kjt7942/grape-sorter/README.md

# grape-sorter

꿀송이농장 포도선별기.

라즈베리파이 + 7인치 터치스크린(800x480)에서 도는 선별 제어 프로그램입니다.
아두이노 메가 2560에 붙은 12채널 로드셀(HX711)에서 무게를 받아, 목표무게에 가장
가까운 조합을 찾아 해당 저울의 LED를 켭니다.

```
[로드셀 x12] --HX711--> [Arduino Mega 2560] --USB 시리얼 115200--> [Raspberry Pi]
                                 ^                                        |
                                 +------------ LED 점등 명령 -------------+
```

## 목적

박스 하나에 포도를 담을 때 목표무게(예: 2,050g)에 최대한 가깝게 맞춰야 하는데,
저울 12개에 흩어진 송이들 중 어떤 조합이 목표에 가장 가까운지 사람이 암산으로
고르기는 어렵습니다. 이 프로그램은 `itertools.combinations` 로 가능한 모든 조합을
전수 탐색해 최적 조합을 즉시 계산하고, 해당 저울의 LED를 켜서 작업자가 어떤
송이를 담아야 하는지 바로 알 수 있게 합니다.

현장(농장)에 무인/반무인으로 배포되는 키오스크 장비라, 개발 과정의 절반은
기능 추가보다 "전원만 넣으면 항상 정상 동작"을 보장하는 데 들어갔습니다 —
OTA 실패 자동 롤백, 시리얼 재연결, 설정 파일 원자적 저장 등 (아래 개발 기록 참고).

## 설치 (라즈베리파이)

```bash
git clone https://github.com/kjt7942/grape-sorter.git
cd grape-sorter
bash setup_kiosk.sh          # X11, PyQt5, PySerial, 자동시작, sudo 권한
sudo bash setup_boot_screen.sh   # (선택) 부팅 스플래시 화면
```

이후 `sudo raspi-config` 에서 Console Autologin 을 켜고 재부팅하면 전체화면으로 자동 실행됩니다.
자세한 절차와 트러블슈팅은 [dev_environment_spec.md](dev_environment_spec.md) 를 보세요.

## 개발 환경에서 실행

아두이노가 없으면 시뮬레이션 모드로 뜹니다. 저울 카드를 클릭해 무게를 만들고 조합 동작을 확인할 수 있습니다.

```bash
python3 main.py
```

## 파일 구성

| 파일 | 역할 |
|---|---|
| `main.py` | 시리얼 통신, 조합 연산, 설정/실적 저장, OTA |
| `main_ui.py` | PyQt5 화면 정의 (메인 + 다이얼로그 3종) |
| `arduino_firmware/` | 아두이노 메가 펌웨어 (로드셀 읽기, LED, 영점) |
| `test_sorter.py` | 조합 로직 자체 점검. PyQt5 없이 실행되며 OTA 검증 관문으로도 쓰임 |
| `tests/` | 화면·시작절차·조립단계별 테스트. [tests/README.md](tests/README.md) 참고 |
| `setup_kiosk.sh` | 라즈베리파이 키오스크 환경 구축 |
| `setup_boot_screen.sh` | 부팅 스플래시(Plymouth) 설정 |

## 실행 중 생기는 파일 (git 추적 안 함)

| 파일 | 내용 |
|---|---|
| `settings.json` | 프리셋 A~H, 저울 보정값, 마지막 설정 |
| `settings.backup.json` | 위 파일의 자동 백업 |
| `production.csv` | 박스 완성 실적 (시각, 목표/실제 무게, 사용 저울) |
| `sorter.log` | 실행 로그 (1MB 회전, 3개 보관) |

## 테스트

라즈베리파이나 아두이노 없이 개발 PC에서 전부 돕니다.

```bash
python3 tests/run_all.py         # 전체 (7개 스위트)
python3 tests/render_screens.py  # 모든 화면을 PNG 로 저장
python3 test_sorter.py           # 조합 로직만 (OTA 관문과 동일)
```

무엇을 지키는지는 [tests/README.md](tests/README.md) 에 정리돼 있습니다.

## 개발 기록

커밋 로그(`git log --reverse`) 기준. 2026-03 구간은 대부분 "Add files via
upload"로 커밋되어 있어 세부 시각별 로그로 재구성할 수 없고, 2026-08 하순부터
의미 단위 커밋 메시지로 남겼습니다.

**2026-03-14 ~ 2026-03-30 — 초기 구축**
PyQt5 UI, 시리얼 통신, 조합 연산 뼈대, 800x480 대응, 키오스크 자동시작 스크립트를
파일 업로드 방식으로 반복 커밋하며 완성.

**2026-08-29**
- 15:42 아두이노 DT/LED 핀 매핑 정리
- 16:05 OTA 시 아두이노 펌웨어 버전(git 커밋 해시)까지 검증하도록 추가
- 16:14 저울점검 다이얼로그 추가 — 12채널 상태, 채널별 LED 확인, 펌웨어 버전 비교
- 22:11 현장 무인 운영 하드닝 — OTA 실패 시 이전 커밋으로 자동 롤백, 시리얼 2초
  간격 자동 재연결, `settings.json` 원자적 저장 + 백업/복구, 시작 시 자동 영점과
  오영점 감지, `print()` 대신 회전 로그 파일
- 22:11 아두이노 — 영점 오프셋을 `[TARE]`로 보고, 커맨드 버퍼 오버플로 복구
- 22:11 `dev_environment_spec.md` / `README.md` 재작성
- 22:18 허브보드 증설·제거 시 오영점으로 오탐하던 버그 수정
- 22:35 오프스크린 테스트 스위트 추가 (하드웨어 없이 검증)
- 22:44 보태기(topup) 모드 실적 기록 버그 수정, 보정 중 LED 오작동 억제
- 22:53 라즈베리파이에 RTC가 없어 생기는 시각 오류 완화 — 미동기화 시 실적에
  "(시각미확인)" 표기

**2026-08-30**
- 14:43 저울 7번(20kg 로드셀) `calFactor` 보정
- 14:46 저울마다 로드셀 용량이 섞여 있어 보정 배율 허용범위 확대
- 14:50 보정 화면 영점대기 안내 폰트 확대
- 18:22 허브보드 3장의 SCK 라인을 각각 분리해 배선 부담 감소
- 18:55 보정 화면에서 저울 카드를 직접 탭해 해당 채널부터 보정 가능하게
- 23:25 버튼 눌림 피드백 추가, 화면 안내문구 정리

**2026-09-11 ~ 09-18**
- 조합 잠금 유지(저울을 일부 비워도 선택 유지), 5g 단위 반올림, 잠금 켜기/끄기 토글
- 저울 3번 `calFactor`를 실측 비율로 재계산
- 잠긴 저울을 전부 비우면 즉시 잠금 해제 후 다음 조합 탐색
- 잠긴 조합무게가 포도 정착으로 늘어난 무게를 따라가되, 0.5초 유지된 값만 반영
- 조합 카드 터치 시 거절·순환 동작 제거 (같은 무게면 같은 최적 조합)

**2026-09-24 — 측정 안정화 (하드웨어 변경 없이)**
빈 저울 실측(10Hz, 채널 노이즈 표준편차 ≤1.1g)으로 기준을 잡고, 원인을 하나씩 좁혀가며 수정.
- 13:35 단발 ERR 이 잠긴 조합을 풀던 버그 수정 — 연속 5회까지 직전 정상값 유지.
  시리얼 수신을 증분 UTF-8 디코딩으로 바꿔 거의 매일 나던 "시작 준비 실패" 해결
- 13:47 새 조합은 무게가 0.5초 안정된 저울로만 잠금 (올리는 중인 송이 제외)
- 13:48 펌웨어 — HX711 준비 판정을 한 번의 스캔으로 통일, SCK HIGH 구간 인터럽트 차단,
  영점을 10회 평균 대신 위아래 2개씩 버린 절사평균으로
- 13:57 물리적으로 불가능한 값(-50g 미만, 25kg 초과)도 깨진 읽기로 보고 직전 값 유지
- 14:09 펌웨어 — HX711 원시값 0·포화값을 실패로 처리. 5번을 제외한 전 채널이 빈 상태
  120초 동안 이상값 0건
- 현장 설정: Wi-Fi 절전 끄기(SDIO 칩 정지 대응), 키오스크 `.xinitrc` 를 재시작 루프 버전으로 교체

## 스크린샷

`tests/render_screens.py` 로 캡처한 실제 화면입니다 (`docs/screenshots/`).

| 메인 화면 (다크) | 저울 정밀 보정 | 저울(로드셀) 점검 |
|---|---|---|
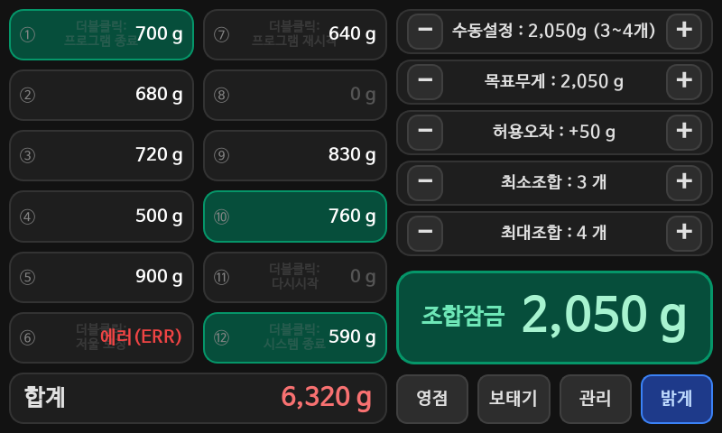
[picture p1: docs/screenshots/01_main_screen.png]
메인 화면
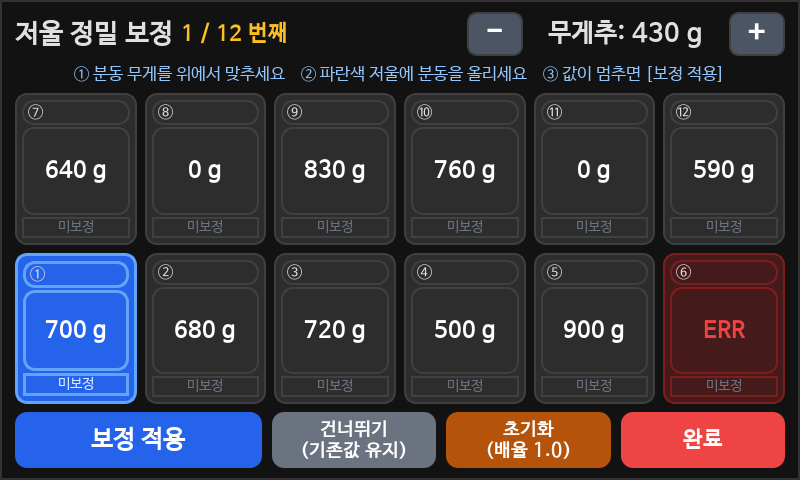
[picture p2: docs/screenshots/02_calibration.png]
보정 화면
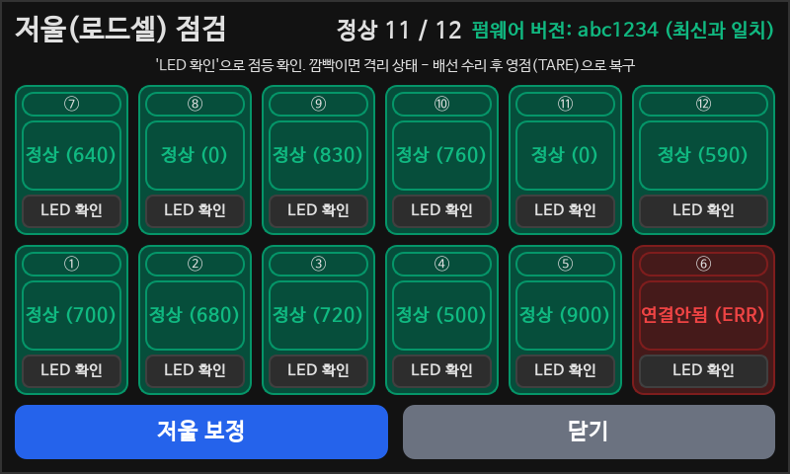
[picture p3: docs/screenshots/03_scale_check.png]
저울점검 화면
|  |  |  |

## 트러블슈팅 · 배운 점

**오영점(bad-tare) 오탐 — 허브보드 증설/제거 시** (`88165ed`)
미배선 채널은 `performTare()`가 오프셋을 갱신하지 못해 무게가 항상 0으로 보고됩니다.
허브보드를 새로 꽂으면 그 채널이 0 → 실제 무게로 바뀌는데, 이걸 "저울에 뭔가 올려진
채 영점을 잡았다"는 오탐으로 판단했습니다. 한쪽 값이 0이면 비교를 건너뛰도록 수정.

**보태기(topup) 모드가 박스 전체가 아닌 보탠 양만 기록** (`be5b197`)
topup 모드에서 `current_target`은 "아직 부족한 양"만 담고 있어서, 2,050g 박스를
1,400g까지 채운 뒤 660g을 보탰다면 실적에는 "목표 650 / 실제 660"으로 남고 화면
표시(2,060g)와 어긋났습니다. 잠긴 조합 옆에 박스 전체 무게를 함께 기록하도록 수정.

**RTC 없는 라즈베리파이의 시각 오류** (`30803c5`)
Pi 3B는 RTC가 없어 부팅 시 `fake-hwclock`이 마지막 종료 시각을 복원합니다. 며칠
전 시각이 그럴듯하게 나오기 때문에 연도만 확인하는 방식으로는 걸러지지 않습니다.
`systemd-timesyncd`에게 실제 동기화 여부를 물어, 미확인 상태면 실적에
"(시각미확인)"을 붙입니다. 근본 해결은 아래 향후 계획 참고.

**혼합 용량 로드셀에서 보정이 항상 실패** (`58ba6ca`, `6359618`)
저울마다 5/10/20kg 로드셀이 섞여 있고 부품 수급에 따라 조합이 바뀌는데, 보정
배율 허용범위(0.5~2.0x)가 동일 용량 내 오차만 커버해서 20kg 셀이 꽂힌 저울은
매번 리젝됐습니다. 허용범위를 넓혀 현장에서 화면으로 재보정 가능하게 했습니다.

**저울점검의 수동 LED가 조합 LED에 묻힘** (`d7c7fa2`)
저울점검 화면에서 특정 채널 LED를 켜도, 조합 연산 루프가 초당 ~10회 같은 LED
명령을 계속 내보내며 100ms 안에 덮어써서 기능이 무력했습니다. 선택된 조합이
바뀔 때만 LED 명령을 보내도록 고쳐서 해결.

**단발 ERR 한 번에 잠긴 조합이 풀림** (`8138d90`)
HX711 이 읽는 순간 준비가 안 돼 저울당 약 30초에 한 번 ERR(-1)이 섞여 왔습니다. 잠금
로직은 0 이하를 "저울을 비웠다"로 보고, 바로 다음 정상값(300g 이상)을 "새 송이"로 봐서
송이가 그대로 있는데 선택을 풀었습니다. 짧은 ERR 은 직전 값으로 메우고, 펌웨어도 대기
루프가 끝난 뒤 핀을 다시 읽던 것을 한 번의 스캔 결과로 판정하도록 고쳐 ERR 자체를 없앴습니다.

**"아두이노가 영점 완료를 알리지 않음" — 한글이 조각 경계에서 잘림** (`8138d90`)
시리얼 조각마다 따로 `decode(errors='ignore')` 해서, 3바이트 한글이 두 조각에 걸치면
버려지고 "영점 조절 완료" 문장이 깨졌습니다. 로그상 거의 매일 한 번씩 시작 절차가
실패했습니다. 증분 디코더로 바꾸고, 모든 바이트 경계에서 잘라 보내는 테스트를 추가했습니다.

**빈 저울이 "-영점÷3" g 으로 튐 — HX711 원시값 0** (`6eac126`)
빈 저울에서 9번 -228g, 4번 -75g, 10번 -86g 이 순간적으로 찍혔는데, 모두 정확히 그 채널
영점값(684/225/259g)의 -1/3 이었습니다. HX711 이 원시값 0을 두 번 연속 보내면 5개 중
가운데 3개 평균 필터가 하나를 걸러내지 못합니다. 같은 이유로 부팅 영점이 한 채널씩 수
kg 틀어졌습니다(-3,774g, -2,005g). 원시값 0·포화값을 실패로 처리하고 영점을 절사평균으로 바꿨습니다.

**Wi-Fi 가 멈춤 — 전원이 아니라 절전 모드**
전압은 정상(`get_throttled=0x0`)인데 `brcmf_sdio_bus_sleep ... -110` 후 칩이 멈췄습니다.
NetworkManager 에서 Wi-Fi 절전을 끄고(`wifi.powersave = 2`) 해결.

## 향후 계획

- **저울 5번 하드웨어 점검** — 펌웨어 수정 후에도 같은 이상값(-12,584g)이 반복되는 유일한
  채널. 소프트웨어가 직전 값으로 메우고 있지만 배선·커넥터·HX711 보드 확인 필요.
  (3번은 고장으로 분리해 둔 상태)
- **자동 영점 추적** — 빈 저울 영점이 시간당 2~6g 흐른다. 하루 운영 데이터를 보고 결정.

- **RTC 모듈(DS3231) 추가** — 현재는 시각 미동기화를 감지해 표기만 할 뿐,
  근본적으로 정확한 시각을 확보하진 못합니다 (`30803c5` 커밋 메시지에 명시).
- **OTA 신뢰 경계 강화** — OTA는 원격 저장소의 코드를 검증 없이 실행하고
  펌웨어까지 자동으로 굽습니다. 저장소 쓰기 권한 최소화와 2단계 인증은
  운영 프로세스로 남아 있고, 코드 서명 등 기술적 검증은 아직 없습니다
  (`dev_environment_spec.md` 6장).
  HTTPS+PAT 자격증명은 라즈베리파이에 평문(`~/.git-credentials`)으로 남으므로
  읽기 전용 자격증명 사용과 기기 분실 시 즉시 폐기가 필요합니다.
