kjt7942/grape-sorter/arduino_firmware/arduino_firmware.ino

#include <string.h>
#include "firmware_version.h"

// --- 핀 설정 ---
const int LOADCELL_COUNT = 12;
// 허브보드 1/2/3의 SCK를 각각 독립된 핀으로 분리. 세 핀 모두 매 순간
// 똑같은 펄스를 동시에 내보내므로(아래 readSensors), 어느 채널이 어느
// 허브에 물려 있는지는 신경 쓸 필요 없다 - 이전처럼 한 몸처럼 동작한다.
const int SCK_PINS[3] = {2, 34, 35};
const int DT_PINS[LOADCELL_COUNT]  = {24, 25, 28, 29, 32, 33, 22, 23, 26, 27, 30, 31};
const int LED_PINS[LOADCELL_COUNT] = { 5,  6,  9, 10, 13, 14,  3,  4,  7,  8, 11, 12};
// --- 영점 및 '개별' 보정 설정 ---
float calFactors[LOADCELL_COUNT] = {
  // 5번(10kg), 7번(20kg), 11번(10kg)은 나머지 5kg 로드셀보다 감도가 낮다.
  // 소프트웨어 배율로만 땜질하면 원시 노이즈까지 그만큼 증폭되므로 여기서 직접 맞춘다.
  //
  // 3번은 용량 스케일링(20kg 가정, 107.4)으로는 470g 분동이 8341g로 찍혀
  // 17.75배 어긋났다. 실측 비율로 역산한 값(107.4 * 8341 / 470)으로 교체.
  // 다른 20kg 채널(7번, 104.5)과 동일 계열 수치로는 안 맞았던 걸로 봐서,
  // 3번 소켓의 로드셀이 실제로는 20kg이 아닐 가능성이 있다 — 현장에서 확인 필요.
  424.0, 425.5, 1906.0, 424.2, 223.9, 422.9,
  104.5, 425.0, 423.5, 424.8, 226.4, 424.0
};
long offsets[LOADCELL_COUNT] = {0}; 

// --- 필터 설정 (슬라이딩 윈도우) ---
const int SAMPLE_SIZE = 5; 
long weightBuffer[LOADCELL_COUNT][SAMPLE_SIZE] = {0};

// --- 산업용 고정 통신 버퍼 ---
const int MAX_CMD_LEN = 64;
char cmdBuffer[MAX_CMD_LEN];
int cmdIndex = 0;
bool cmdReady = false;

// --- 🌟 5진 아웃 & 상태 저장 변수 🌟 ---
bool ledCommandState[LOADCELL_COUNT] = {false}; 
unsigned long lastBlinkTime = 0;                
bool blinkState = false;                        

int errorCount[LOADCELL_COUNT] = {0};       // 채널별 에러 누적 카운터 (5진 아웃용)
bool isIsolated[LOADCELL_COUNT] = {false};  // 격리(블랙리스트) 상태 

// --- 함수 선언 ---
void readSensors(long* targetArray, bool* successArray);
void performTare();

void setup() {
  delay(1000); // 🌟 필수 추가: 전원 인가 후 로드셀이 깨어날 때까지 1초 대기
  Serial.begin(115200);
  for (int s = 0; s < 3; s++) {
    pinMode(SCK_PINS[s], OUTPUT);
    digitalWrite(SCK_PINS[s], LOW);
  }
  
  for(int i = 0; i < LOADCELL_COUNT; i++) {
    // 🚨 핵심 수술: 아두이노 내부에 5V 저항을 강제로 연결하여 노이즈 원천 차단!
    pinMode(DT_PINS[i], INPUT_PULLUP); 
    pinMode(LED_PINS[i], OUTPUT);
    digitalWrite(LED_PINS[i], LOW);
  }

  performTare();
  Serial.print("[VER] ");
  Serial.println(FIRMWARE_VERSION);
  Serial.println("--- 24시간 무중단 모드 (5진 아웃 격리 시스템 가동 중) ---");
}

void loop() {
  // 1. 라즈베리파이 명령 수신
  while (Serial.available() > 0) {
    char c = Serial.read();
    if (c == '\n') {
      cmdBuffer[cmdIndex] = '\0'; 
      cmdReady = true;
      break; 
    } 
    else if (c != '\r') {
      if (cmdIndex < MAX_CMD_LEN - 1) {
        cmdBuffer[cmdIndex++] = c;
      } else {
        // 개행 없이 버퍼를 넘긴 쓰레기 입력. 비우지 않으면 이후 명령이 전부 무시된다.
        cmdIndex = 0;
      }
    }
  }

  // 2. 명령어 파싱
  if (cmdReady) {
    char *startPtr = strchr(cmdBuffer, '<'); 
    char *endPtr = strchr(cmdBuffer, '>');   

    if (startPtr != NULL && endPtr != NULL && startPtr < endPtr) {
      *endPtr = '\0'; 
      char *innerCmd = startPtr + 1; 

      if (strcmp(innerCmd, "TARE") == 0) {
        performTare();
      }
      else if (strcmp(innerCmd, "VER") == 0) {
        Serial.print("[VER] ");
        Serial.println(FIRMWARE_VERSION);
      }
      else {
        for (int i = 0; i < LOADCELL_COUNT; i++) ledCommandState[i] = false;
        
        char *token = strtok(innerCmd, ", ");
        while (token != NULL) {
          int ledNum = atoi(token); 
          if (ledNum >= 1 && ledNum <= LOADCELL_COUNT) {
            ledCommandState[ledNum - 1] = true;
          }
          token = strtok(NULL, ", "); 
        }
      }
    }
    cmdIndex = 0;
    cmdReady = false;
  }

  // 3. 센서 데이터 동시 읽기 및 5진 아웃 판정
  long rawValues[LOADCELL_COUNT] = {0};
  bool successArray[LOADCELL_COUNT] = {false};
  
  readSensors(rawValues, successArray);

  for (int i = 0; i < LOADCELL_COUNT; i++) {
    if (isIsolated[i]) {
      continue;
    }

    if (successArray[i]) {
      errorCount[i] = 0; 
    } else {
      errorCount[i]++;
      if (errorCount[i] >= 5) {
        isIsolated[i] = true; 
      }
    }
  }

  // 4. 라즈베리파이로 데이터 송신
  Serial.print("<");
  for (int i = 0; i < LOADCELL_COUNT; i++) {
    if (!isIsolated[i] && successArray[i]) {
      float weight = (rawValues[i] - offsets[i]) / calFactors[i];

      for (int j = 0; j < SAMPLE_SIZE - 1; j++) {
        weightBuffer[i][j] = weightBuffer[i][j + 1];
      }
      weightBuffer[i][SAMPLE_SIZE - 1] = (long)weight;

      long temp[SAMPLE_SIZE];
      for (int k = 0; k < SAMPLE_SIZE; k++) temp[k] = weightBuffer[i][k];
      for (int m = 0; m < SAMPLE_SIZE - 1; m++) {
        for (int n = m + 1; n < SAMPLE_SIZE; n++) {
          if (temp[m] > temp[n]) {
            long t = temp[m]; temp[m] = temp[n]; temp[n] = t;
          }
        }
      }

      long filteredWeight = (temp[1] + temp[2] + temp[3]) / 3;
      if (filteredWeight > -2 && filteredWeight < 2) filteredWeight = 0;

      Serial.print(filteredWeight);
    } else {
      Serial.print("ERR");
    }
    
    if (i < LOADCELL_COUNT - 1) Serial.print(", ");
  }
  Serial.println(">");

  // 5. LED 최종 출력 제어 (비상 깜빡임 vs 정상 명령)
  if (millis() - lastBlinkTime >= 100) { 
    blinkState = !blinkState;
    lastBlinkTime = millis();
  }

  for (int i = 0; i < LOADCELL_COUNT; i++) {
    if (isIsolated[i]) {
      digitalWrite(LED_PINS[i], blinkState ? HIGH : LOW);
    } else {
      digitalWrite(LED_PINS[i], ledCommandState[i] ? HIGH : LOW);
    }
  }

  delay(50); 
}

// --- 🌟 개선된 영점 조절 (격리 해제 기능 포함) 🌟 ---
void performTare() {
  Serial.println("\n[SYSTEM] 영점 조절(TARE) 및 에러 초기화 시작...");
  
  for(int i = 0; i < LOADCELL_COUNT; i++) {
    errorCount[i] = 0;
    isIsolated[i] = false;
  }

  // 단순 평균은 깨진 값 하나에 영점 전체가 수 kg 틀어진다(현장 로그: 부팅 영점에서
  // 5번 -3774g, 6번 -2005g). 채널별로 모아 정렬한 뒤 위아래 TARE_TRIM 개씩 버린다.
  const int TARE_READS = 10;
  const int TARE_TRIM = 2;
  static long samples[LOADCELL_COUNT][TARE_READS];
  int validReads[LOADCELL_COUNT] = {0};

  for(int k = 0; k < TARE_READS; k++) {
    long rawValues[LOADCELL_COUNT] = {0};
    bool successArray[LOADCELL_COUNT] = {false};

    readSensors(rawValues, successArray);

    for(int i = 0; i < LOADCELL_COUNT; i++) {
      if (successArray[i]) {
        samples[i][validReads[i]++] = rawValues[i];
      }
    }
    delay(50);
  }

  for(int i = 0; i < LOADCELL_COUNT; i++) {
    int n = validReads[i];
    if (n > 0) {
      long *s = samples[i];
      for (int m = 0; m < n - 1; m++) {
        for (int q = m + 1; q < n; q++) {
          if (s[m] > s[q]) { long t = s[m]; s[m] = s[q]; s[q] = t; }
        }
      }
      // 표본이 적으면(대부분 실패한 채널) 버릴 여유가 없으니 가운데 값만 쓴다.
      int lo = (n > 2 * TARE_TRIM) ? TARE_TRIM : (n - 1) / 2;
      int hi = n - lo;
      long sum = 0;
      for (int m = lo; m < hi; m++) sum += s[m];
      offsets[i] = sum / (hi - lo);
    }
    for(int j = 0; j < SAMPLE_SIZE; j++) weightBuffer[i][j] = 0;
  }

  // 이번에 0으로 만든 무게를 그램으로 보고한다.
  // 접시만 올려져 있으면 매번 비슷한 값이 나오고, 포도가 올려진 채로 영점을
  // 잡으면 값이 크게 튄다. 라즈베리파이가 이걸 지난번 값과 비교해 경고한다.
  Serial.print("[TARE] ");
  for(int i = 0; i < LOADCELL_COUNT; i++) {
    Serial.print((long)(offsets[i] / calFactors[i]));
    if (i < LOADCELL_COUNT - 1) Serial.print(",");
  }
  Serial.println();

  Serial.println("[SYSTEM] 영점 조절 완료! 정상 가동 재개.");
}

// --- 🌟 개선된 초고속 동시 읽기 함수 (60us 수면 버그 원천 차단) 🌟 ---
void readSensors(long* targetArray, bool* successArray) {
  unsigned long startTime = millis();
  bool ready[LOADCELL_COUNT];

  // 센서들이 준비될 때까지 대기. 판정은 한 번 훑은 결과(ready)로만 한다.
  // 예전에는 대기가 끝난 뒤 핀을 다시 읽어 성공 여부를 정했는데, 그 사이
  // 다음 변환이 끝나는 칩은 DOUT 이 잠깐 HIGH 로 튀어 ERR 로 찍혔다
  // (실측 저울당 약 30초에 1회).
  while (true) {
    bool allReady = true;
    for (int i = 0; i < LOADCELL_COUNT; i++) {
      ready[i] = isIsolated[i] || digitalRead(DT_PINS[i]) == LOW;
      if (!ready[i]) allReady = false;
    }
    if (allReady || millis() - startTime >= 150) break;
  }

  for (int i = 0; i < LOADCELL_COUNT; i++) {
    successArray[i] = !isIsolated[i] && ready[i];
  }

  long values[LOADCELL_COUNT] = {0};

  // 24번의 펄스를 발생시켜 데이터를 동시에 빨아들임
  for (int i = 0; i < 24; i++) {
    // SCK 가 60us 넘게 HIGH 면 HX711 이 절전으로 빠진다. 그 사이에 타이머/시리얼
    // 인터럽트가 끼어들지 않도록 HIGH 구간만 막는다(수 us라 수신 손실 없음).
    noInterrupts();
    digitalWrite(SCK_PINS[0], HIGH);
    digitalWrite(SCK_PINS[1], HIGH);
    digitalWrite(SCK_PINS[2], HIGH);
    delayMicroseconds(1);       // 1. 아주 짧게 전기를 쏜다 (1마이크로초)
    digitalWrite(SCK_PINS[0], LOW); // 2. 🚨 즉시 끈다! (수면 모드 절대 진입 불가)
    digitalWrite(SCK_PINS[1], LOW);
    digitalWrite(SCK_PINS[2], LOW);
    interrupts();

    // 3. 전기가 꺼진 안전한 상태에서 느긋하게 12개의 핀을 다 읽는다!
    int b0  = digitalRead(DT_PINS[0]);
    int b1  = digitalRead(DT_PINS[1]);
    int b2  = digitalRead(DT_PINS[2]);
    int b3  = digitalRead(DT_PINS[3]);
    int b4  = digitalRead(DT_PINS[4]);
    int b5  = digitalRead(DT_PINS[5]);
    int b6  = digitalRead(DT_PINS[6]);
    int b7  = digitalRead(DT_PINS[7]);
    int b8  = digitalRead(DT_PINS[8]);
    int b9  = digitalRead(DT_PINS[9]);
    int b10 = digitalRead(DT_PINS[10]);
    int b11 = digitalRead(DT_PINS[11]);

    // 읽은 비트를 합친다
    values[0]  = (values[0]  << 1) | b0;
    values[1]  = (values[1]  << 1) | b1;
    values[2]  = (values[2]  << 1) | b2;
    values[3]  = (values[3]  << 1) | b3;
    values[4]  = (values[4]  << 1) | b4;
    values[5]  = (values[5]  << 1) | b5;
    values[6]  = (values[6]  << 1) | b6;
    values[7]  = (values[7]  << 1) | b7;
    values[8]  = (values[8]  << 1) | b8;
    values[9]  = (values[9]  << 1) | b9;
    values[10] = (values[10] << 1) | b10;
    values[11] = (values[11] << 1) | b11;
  }
  
  // 마지막 25번째 펄스 (다음 데이터를 위해 필수)
  noInterrupts();
  digitalWrite(SCK_PINS[0], HIGH); digitalWrite(SCK_PINS[1], HIGH); digitalWrite(SCK_PINS[2], HIGH);
  delayMicroseconds(1);
  digitalWrite(SCK_PINS[0], LOW); digitalWrite(SCK_PINS[1], LOW); digitalWrite(SCK_PINS[2], LOW);
  interrupts();
  delayMicroseconds(1);

  // 음수 처리 등 최종 마무리
  for (int i = 0; i < LOADCELL_COUNT; i++) {
    if (successArray[i]) {
      if (values[i] & 0x800000) values[i] |= 0xFF000000;
      // 원시값 0(비트 전부 0)과 포화값은 실제 무게가 아니라 깨진 읽기다. 현장 실측에서
      // 빈 저울이 가끔 원시값 0을 두 번 연달아 보내, 필터를 뚫고 '-영점/3' g
      // (9번 -228g, 4번 -75g 등)으로 튀었다. 실패로 처리해 필터에 넣지 않는다.
      if (values[i] == 0 || values[i] == 0x7FFFFFL || values[i] == -0x800000L) {
        successArray[i] = false;
      } else {
        targetArray[i] = values[i];
      }
    }
  }
}
