kjt7942/grape-sorter/(commit log)

2026-03-13 Add files via upload
    텍스트 수정 및 설치스크립트 업데이트
    - 일시 중지됨 -> 일시정지
    [main.py]
2026-03-18 Add files via upload
    제품등록 기능 추가
2026-03-19 Add files via upload
    같은 오차일경우 더 많은 조합을 선택하도록 개선하여 회전율 향상
2026-03-19 Add files via upload
    보태기모드추가, 화면떨림 버그수정
    [main.py, main_ui.py]
2026-03-21 Add files via upload
    아두이노 펌웨어 업데이트기능 포함
2026-03-21 Add files via upload
    영점조정기능 안정화
    저울보정 기능추가 진행중
2026-03-29 Add files via upload
    1. 조합잠금 기능추가
    2. 시뮬레이션 모드 보완
2026-08-29 Update DT/LED pin mapping in arduino firmware
2026-08-29 Add firmware version verification to OTA update flow
    Embed the git commit hash in the Arduino sketch at compile time and
    have it print [VER] <hash> on boot, then have the Raspberry Pi
    re-open the serial port after upload to confirm the running firmware
    actually matches what was just pulled from GitHub, instead of only
    trusting arduino-cli's upload exit code.
2026-08-29 Add scale check dialog for load cell and firmware diagnostics
    Add a "저울점검" button to the product registration screen that opens
    a dialog showing live per-channel status (연결됨/ERR) for all 12 load
    cells, an LED-toggle button per channel to visually trace wiring, and
    the firmware version currently running on the Arduino compared against
    the latest local git commit, so a mismatch or dead channel is obvious
    without reading serial logs.
    Arduino side: add a <VER> command that replies with the firmware
    version on demand (previously only printed once at boot).
2026-08-29 feat(firmware): report tare offsets and recover from oversized commands
    performTare() now prints "[TARE] o1,...,o12" with the weight (in grams)
    that was zeroed out on each channel. The Pi stores these and compares them
    across sessions: if a channel jumps by more than 100g, fruit was probably
    sitting on the plate when the tare ran, which would silently zero out real
    weight and ship underweight boxes.
    Printed before the "영점 조절 완료" line so the Pi has the offsets in hand
    before the completion signal fires.
    Also reset cmdIndex when the command buffer overflows. Previously, input
    longer than 64 bytes without a newline left the index pinned at the limit
    and every subsequent command wa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
    [arduino_firmware.ino]
2026-08-29 feat: harden field operation, add startup tare and rework calibration
    This machine runs unattended on a touch-only kiosk with no keyboard, so
    every failure mode below previously required cutting power to recover.
    Recovery and reliability
    - OTA no longer escapes exceptions. A failed git pull used to leave the
    fullscreen "do not power off" overlay latched with no way out.
    - OTA verifies the new code with test_sorter.py and resets --hard back to
    the pre-pull commit if it fails, so a broken push cannot brick a device.
    - Every overlay now carries an auto-dismiss deadline, and tapping the
    screen closes it. The tare overlay depended on an Arduino reply that may
    never arrive.
    - Serial recon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
    [main.py, main_ui.py, test_sorter.py]
2026-08-29 chore: harden kiosk setup, ignore runtime files, drop dead script
    setup_kiosk.sh
    - Derive the app path from the script location instead of hardcoding
    ~/포도선별기, removing a manual step that had to match exactly.
    - Restart the app automatically if it exits non-zero. Without a window
    manager a crash dropped the operator to a bare console. A clean exit
    (card 1 double-tap) still leaves the loop.
    - Grant passwordless sudo for reboot and shutdown only, via
    /etc/sudoers.d/grape-sorter with a visudo syntax check. The card 11 and
    12 shortcuts silently did nothing without it.
    .gitignore now covers the per-device settings, its backup, production.csv
    and the rotating log.
    update_fonts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
2026-08-29 docs: rewrite the spec and README for the current system
    dev_environment_spec.md
    - Document the serial protocol in both directions, the physical 2x6 scale
    layout and why the main screen rotates it to 6x2, the startup tare
    sequence, bad-tare detection, the recombination gesture, the shortfall
    readout, production.csv, and the settings backup chain.
    - Rewrite the calibration section: tare and calibration are different
    operations and the old text conflated them. Records the 430g reference
    weight and notes that the firmware's calFactors are load-cell
    sensitivity, not a weight to be adjusted.
    - Point troubleshooting at sorter.log first, since the kiosk hides the
    console.
    - Remove the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
2026-08-29 fix: do not flag added or removed hub boards as a bad tare
    performTare() leaves an offset untouched when a channel never reads
    successfully, so an unwired channel reports 0. Wiring up a hub board moved
    that channel from 0 to the plate weight, which the drift check read as
    "something is sitting on the plate" and warned about on the first boot
    after assembly. Removing a board tripped it the same way.
    Skip the comparison whenever either side is 0. A genuine load on a wired
    channel still trips the check.
    Claude-Session: https://claude.ai/code/session_01JM8ktxYYnAyEj7Dx1rRKfq
    [main.py]
2026-08-29 test: add the offscreen test suite used to verify this machine
    These checks were written while debugging the field failures fixed in
    d7c7fa2 and 88165ed. Keeping them makes the next change verifiable without
    a Raspberry Pi or an Arduino: Qt runs offscreen and a fake serial port
    records the bytes that would go to the Arduino.
    python3 tests/run_all.py
    Each suite runs in its own process because QApplication and the main
    module hold global state that would otherwise leak between them.
    - test_layout: everything fits 800x480, overlays dismiss themselves.
    - test_leds: the eight LED paths, including that suppressing duplicate
    writes never swallows a signal that has to go out (a reconnect re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
2026-08-29 fix: record whole-box weight in topup mode, mute LEDs during calibration
    production.csv was recording the top-up portion instead of the box. In
    topup mode current_target is only the amount still needed, so a 2,050g box
    filled to 1,400g and topped up with 660g was logged as "target 650, actual
    660" while the screen showed 2,060g. Useless as a shipping record. Keep the
    box weight alongside the locked combination and log target plus total.
    Combination LEDs also kept firing while the calibration screen was open.
    The operator moves the reference weight from scale to scale, so the
    combination changes constantly and the LEDs chase it, obscuring which
    scale is currently being calibrated. Gate emit_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
    [main.py]
2026-08-29 feat: mark production rows written with an unsynchronised clock
    The Pi 3B has no RTC. On boot fake-hwclock restores the last shutdown
    time, so a stale clock reads as a plausible date a few days off rather
    than 1970 — a year check would not catch it. Ask systemd-timesyncd
    whether the clock actually synchronised instead.
    Untrusted timestamps get a "(시각미확인)" suffix in production.csv so a
    shipping record cannot silently carry a wrong time, and the screen says so
    once per session. Where timesyncd is not in use (chrony and friends) there
    is no way to tell, so fall back to a year sanity check rather than warning
    without grounds.
    A DS3231 would fix this properly; this only stops a wron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
    [main.py]
2026-08-30 fix(firmware): correct calFactor for scale 7's 20kg load cell
    Scale 7 uses a 20kg-rated cell while all others are 5kg, so it needs
    a proportionally smaller calFactor (~1/4) to report accurate grams.
    Using the shared 5kg default made calibration always reject it
    (measured weight ~4x low, tripping the 0.5-2.0x sanity check).
    [arduino_firmware.ino]
2026-08-30 fix: widen calibration ratio sanity range for mixed load cell capacities
    The scale slots use a mix of 5/10/20kg load cells and the exact mix
    changes over time depending on replacement part availability. The old
    0.5-2.0x range only tolerated normal manufacturing variance within a
    single capacity, so any channel with a different-capacity cell always
    failed calibration. Widening it lets an operator recalibrate a swapped
    sensor from the touchscreen without a firmware change each time.
    [main.py]
2026-08-30 fix(ui): enlarge calibration tare message to match main screen
    The "taring in progress" guide text was a small 12pt inline label,
    easy to miss compared to the main screen's big tare overlay. It now
    switches to a large bold font while busy and back to normal once
    ready for input.
    [main_ui.py]
2026-08-30 feat(firmware): split shared SCK line across 3 hub board pins
    Hub boards 1/2/3 all shared a single SCK pin (D2), which the
    assembler wants to avoid. Each hub now gets its own SCK pin
    (2, 34, 35) driven with identical pulses in lockstep, so the
    existing simultaneous 24-clock read of all 12 DT lines is unchanged
    - only the electrical fan-out per pin is reduced.
    [arduino_firmware.ino]
2026-08-30 feat(ui): let the operator tap any scale card to calibrate it directly
    Calibration always had to walk channels 1-12 in order even when only
    one scale needed a redo. The channel cards are now clickable and jump
    cal_target_idx straight to whichever one was tapped (skipping
    disconnected channels), so a single scale can be recalibrated without
    stepping through the rest.
    [main.py, main_ui.py]
2026-08-30 fix(ui): sharpen touch feedback and clarify on-screen guidance
    Buttons gave almost no visible response when tapped (dark theme had no
    :pressed/:hover rules at all), and several guide messages were easy to
    miss or got clipped:
    - add clear pressed/hover colors to every themed button, including the
    calibration dialog's inline-styled buttons
    - show the calibration tare wait as a full-screen dark overlay+scrim,
    matching the main screen's tare overlay, and preview it in
    simulation mode too since there's no hardware to trigger it
    - announce topup mode on/off with the same overlay so the operator
    re-tares the box trays at the right time
    - shorten the scale-check guide text so it stops clipp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
    [main.py, main_ui.py]
2026-08-31 fix(firmware): correct calFactor for scale 3/5/11's non-5kg load cells
    Scale 3 (20kg) and scales 5/11 (10kg) were still using the shared 5kg
    calFactor, same issue scale 7 had before it was fixed. The widened
    calibration ratio sanity range let the software cal_multiplier paper
    over the mismatch (~4x and ~2x), but that also amplifies raw sensor
    noise by the same factor - a channel 3 reboot tare drift of a few
    hundred raw units was showing up as ~7800g of phantom weight on an
    empty plate.
    New calFactors derived from each channel's current cal_multiplier
    (calFactor_old / cal_multiplier) so the fix lines up with the actual
    calibrated reading instead of a theoretical capacity ratio.
    [arduino_firmware.ino]
2026-08-31 fix(ui): stop auto-closing the calibration screen after scale 12
    update_cal_dialog_ui closed the dialog once cal_target_idx walked
    past LOADCELL_COUNT, a leftover from when calibration was strictly
    sequential. Now that any card can be tapped directly, finishing scale
    12 first (or landing there after a skip) shouldn't force the operator
    back to the main screen - clamp to the last card instead and let
    [완료] be the only way out.
    [main.py]
2026-09-03 docs: expand README into portfolio-ready dev log
    Add purpose, chronological dev history from commit log, real screen
    captures, and troubleshooting notes sourced from past commit messages
    (bad-tare false positive, topup logging bug, RTC-less clock, mixed
    load-cell calibration, LED overwrite), plus known gaps (RTC, OTA trust
    boundary).
    Claude-Session: https://claude.ai/code/session_01ML4ptpTCG327kFXcgKX7na
2026-09-11 feat(ui): sticky combo lock, 5g rounding, lock on/off toggle
    Scale readings jittered at 1g resolution and momentarily-zero readings
    kicked scales out of a locked combo mid-pick, which was confusing on
    real hardware.
    - Round calibrated weights to 5g steps for display and combo math.
    - While combo-locked, an emptied scale keeps its selection and LED lit
    indefinitely instead of dropping out; it's only released once a new
    bunch (>=300g) lands on it, so box completion still records once per
    combo but the operator isn't confused by noise flicker.
    - Add a 관리 screen toggle to disable locking entirely (recompute every
    tick, no production recording) for install/debug use.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
    [main.py, main_ui.py]
2026-09-11 fix(firmware): re-derive scale 3's calFactor from measured ratio
    Scale 3's calFactor (107.4, scaled for an assumed 20kg cell like
    channel 7's 104.5) read a 470g reference weight as 8341g, 17.75x too
    high and stable across repeated measurements, so it's not noise. Back
    out the correct factor from the measured ratio: 107.4 * 8341 / 470 ~
    1906.0. Channel 7's near-identical factor calibrates fine, so scale
    3's physical load cell may not actually be the assumed 20kg unit —
    worth checking in the field.
    Claude-Session: https://claude.ai/code/session_01PjLSXvxTe2PHAnRLYsNPVh
    [arduino_firmware.ino]
2026-09-11 fix(ui): release combo lock immediately once all scales are emptied
    The sticky lock (added earlier this session) kept every scale in a
    locked combo selected until it was individually refilled with a new
    300g+ bunch. That meant a fully-packed box stayed "locked" forever
    instead of freeing the scales for the next combo, since nothing had
    been placed back on them yet.
    Now, once every originally-locked scale reads 0 at once (the whole
    box was removed), record the box and drop the lock immediately in
    the same tick, so a new combo is searched from the remaining scales
    right away. Partial removal (some scales still holding weight) still
    keeps the emptied scale's selection/LED lit until refilled, w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
    [main.py]
2026-09-18 fix(ui): keep locked combo weight tracking live weight gains
    The "조합잠금" total was frozen at the exact moment a combo locked and
    never touched again, while each tray's own label and the "합계" sum
    kept showing live weight. Real grape bunches settle for a bit after
    being placed, so a tray already in the combo often gains weight after
    locking — the frozen total then permanently disagreed with the tray
    labels and the live sum, even though nothing was picked up yet.
    Track a running high-water mark instead: sum the live weight of scales
    still on the plate plus the weight each emptied scale had right before
    it was picked (frozen at that instant), and only let the locked total
    increase,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
    [main.py]
2026-09-18 fix(ui): require weight to hold steady before updating locked combo total
    The previous fix tracked a running high-water mark of the locked
    combo's live weight, but that meant a momentary hand press while
    placing grapes (weight spikes, then drops back once the hand lifts)
    got baked into the total permanently, since the mark only ever went up.
    Replace it with a stability gate: a new total is only committed once
    the same value has held for SETTLE_STABLE_SEC (0.5s), which lets real
    settling catch up while filtering out brief touches. Once any scale in
    the combo starts being picked (reads 0), stop updating the total
    entirely — the box's weight is now decided, matching what gets written
    to prod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
    [main.py]
2026-09-18 refactor(ui): drop reject-and-cycle behavior from the combo card tap
    Tapping the combo weight card used to add the current combo to a
    rejected set so the deterministic search would be forced onto a
    different one. Simplify: just clear the lock and re-search fresh. If
    the current combo is still the unique best, it's fine for it to come
    back — the operator asked to re-check, not to force variety.
    This makes the app-side rejected_combos bookkeeping (and the occupancy
    tracking that only existed to invalidate it) dead weight, so it's
    removed along with it. best_combination()'s excluded= parameter stays,
    since it's still an exercised, useful capability of the search itself
    (test_sorter.py's OTA-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
2026-09-24 fix(serial): hold transient ERR packets and decode UTF-8 across read chunks
    - A single ERR from an HX711 that wasn't ready at read time reached the
    lock logic as -1, which it treated as "scale emptied"; the next normal
    reading then looked like a refill and dropped that scale from the locked
    combo. Measured on site: about one ERR per scale every 30s. Up to
    ERR_HOLD_PACKETS (5, matching the firmware's isolation threshold)
    consecutive ERR or garbled values now repeat the last good reading.
    - Each serial chunk was decoded on its own with errors='ignore', so a
    Korean character split across chunks was dropped and
    "[SYSTEM] 영점 조절 완료" never matched. This is the near-daily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
    [main.py]
2026-09-24 fix(combo): lock a new combination only from scales whose weight has settled
    The settle check only guarded updates to an already-locked total; the lock
    itself was taken on the first tick a valid combination existed, so a scale
    still being loaded (or brushed by a hand) could be locked at a transient
    value. A scale now joins the lock candidates once its weight has stayed
    within WEIGHT_STEP for LOCK_STABLE_SEC (0.5s). Scales already sitting
    still are unaffected, so the next combo after a box is cleared still locks
    immediately.
    Tests default LOCK_STABLE_SEC to 0 so single-tick checks keep working; a
    dedicated check turns it on.
    [main.py]
2026-09-24 fix(serial): treat physically impossible weights as corrupt reads
    A 90s capture on empty scales showed scale 5 emitting -67g three packets
    in a row and, earlier, -25,139g. Such values arrive as numbers, not ERR,
    so they bypassed the ERR hold and hit the lock logic as "emptied"; the
    next normal reading then looked like a refill and dropped the scale from
    the locked combo. Values below PLAUSIBLE_MIN_G (-50g) or above
    PLAUSIBLE_MAX_G (25kg) now go through the same last-good-value hold.
    [main.py]
2026-09-24 fix(firmware): consistent HX711 ready snapshot and outlier-proof tare
    - readSensors decided success from a second pin read after the wait loop.
    A chip finishing its next conversion in between briefly pulls DOUT high
    and was reported as ERR (about once per scale every 30s on site). Use
    the same scan that ended the wait.
    - Guard the SCK high pulses with noInterrupts() so a timer/serial ISR
    can't stretch them toward the HX711's 60us power-down threshold.
    - performTare averaged 10 raw readings, so one corrupt sample shifted the
    zero by kilograms (boot-time tare logs: ch5 -3774g, ch6 -2005g, both
    back to normal on the next tare). Sort each channel's samples and drop
    the two highest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
    [arduino_firmware.ino]
2026-09-24 fix(firmware): reject all-zero and saturated HX711 reads
    With the ready-snapshot fix ERRs dropped to zero, but empty scales still
    spiked negative: ch9 -228g, ch4 -75g, ch10 -86g, ch2 -89g. Each equals
    exactly -(tare offset)/3, i.e. the HX711 returned raw 0 twice in a row;
    two bad samples out of five survive the trimmed-median filter at a third
    of their size. A genuine raw 0 is practically impossible, so treat 0 and
    the saturation codes as a failed read (ERR, held by the Pi) instead of
    feeding them to the filter or the tare.
    [arduino_firmware.ino]
2026-09-24 docs: log 2026-09-11..09-24 work in README dev log
    Add the missing 09-11..09-18 combo-lock entries and the 09-24 measurement
    stabilization pass (ERR hold, UTF-8 chunk decoding, settle-before-lock,
    plausibility filter, HX711 firmware fixes), with troubleshooting notes and
    next steps (scale 5 hardware check, zero tracking). Update the tests table.
